ihsan-sa/LED_Light_Panels/USBC_Light_Simple/3D_Models/USB4056-03-A.stp

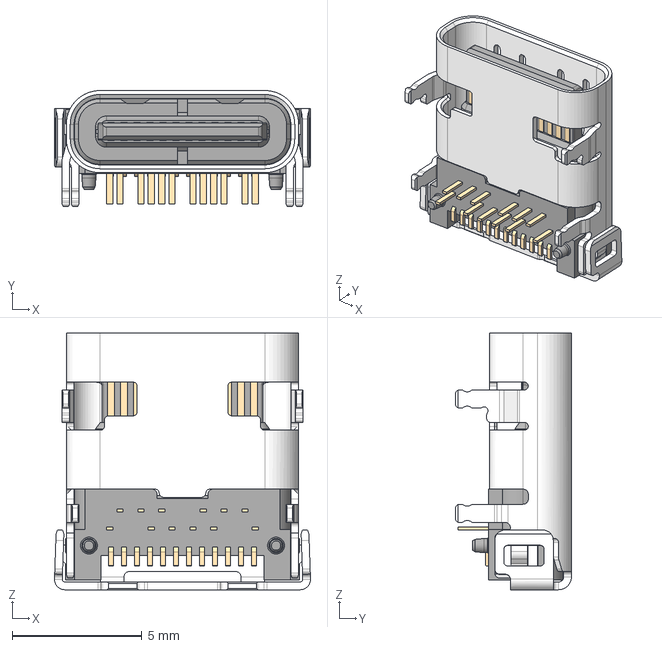
[picture p1: CAD file, 2025-09-14]
USBC_Light_Simple/3D_Models/USB4056-03-A.stp
9.85 x 4.46 x 9.87 mm
