ihsan-sa/LED_Light_Panels/2_LED_WIWO_Compact_Panel/2_LED_WIWO_Compact_Panel/2_LED_WIWO_Compact_Panel.kicad_pcb

## KiCad design 2_LED_WIWO_Compact_Panel/2_LED_WIWO_Compact_Panel/2_LED_WIWO_Compact_Panel.kicad_pcb (2025-10-06)

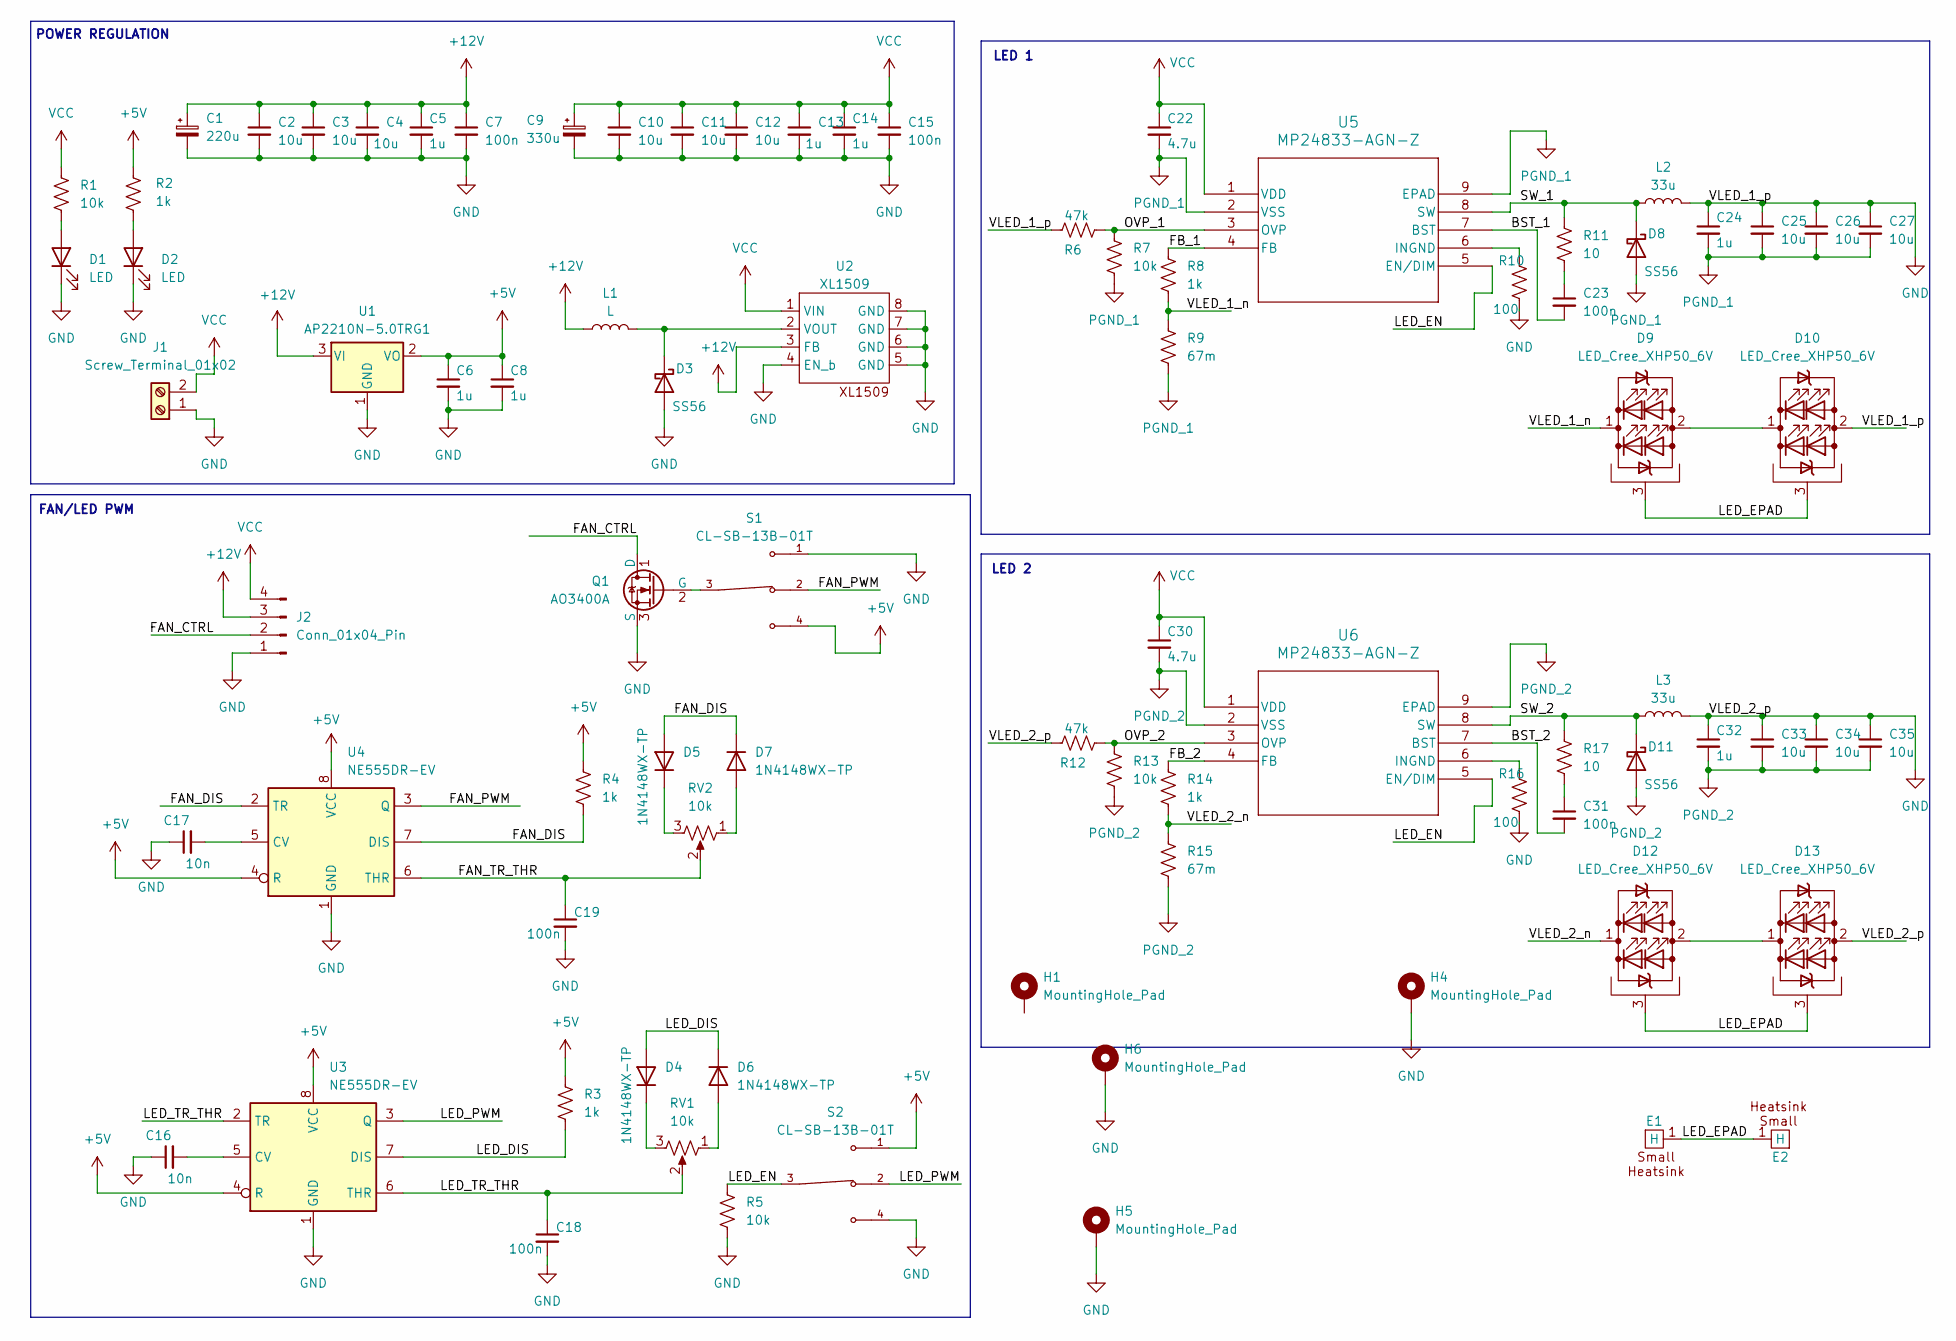
[picture p2: schematic 2_LED_WIWO_Compact_Panel.kicad_sch]

Parts:
C1: 220u; CAP_6.3 X 7.7_PAN
C2, C3, C4, C10, C11, C12, C25, C26, C27, C33, C34, C35: 10u; C_0603_1608Metric_Pad1.08x0.95mm_HandSolder
C5, C6, C8, C13, C14: 1u; C_0402_1005Metric_Pad0.74x0.62mm_HandSolder
C7, C15: 100n; C_0201_0603Metric_Pad0.64x0.40mm_HandSolder
C9: 330u; CAPAE1030X1050N
C16, C17: 10n; R_0201_0603Metric_Pad0.64x0.40mm_HandSolder
C18, C19: 100n; R_0402_1005Metric_Pad0.72x0.64mm_HandSolder
C22, C30: 4.7u; C_0603_1608Metric_Pad1.08x0.95mm_HandSolder
C23, C31: 100n; C_0603_1608Metric_Pad1.08x0.95mm_HandSolder
C24, C32: 1u; C_0603_1608Metric_Pad1.08x0.95mm_HandSolder
D1, D2: LED; LED_0603_1608Metric_Pad1.05x0.95mm_HandSolder
D3, D8, D11: SS56; D_SMA_Handsoldering
D4, D5, D6, D7: 1N4148WX-TP; D_SOD-323_HandSoldering
D9, D10, D12, D13: LED_Cree_XHP50_6V; LED_Cree-XHP50_6V
E1, E2: small_heatsink
H1, H4, H5, H6: MountingHole_Pad; MountingHole_3.2mm_M3_Pad
J1: Screw_Terminal_01x02; TerminalBlock_MaiXu_MX126-5.0-02P_1x02_P5.00mm
J2: Conn_01x04_Pin; PinHeader_1x04_P2.54mm_Vertical
L1: L; CDRH127L125NP-680MC
L2, L3: 33u; IND_SRP1265A-330M
Q1: AO3400A; SOT-23_Handsoldering
R1, R5, R7, R13: 10k; R_0402_1005Metric_Pad0.72x0.64mm_HandSolder
R2, R3, R4, R8, R14: 1k; R_0402_1005Metric_Pad0.72x0.64mm_HandSolder
R6, R12: 47k; R_0402_1005Metric_Pad0.72x0.64mm_HandSolder
R9, R15: 67m; R_2512_6332Metric_Pad1.40x3.35mm_HandSolder
R10, R16: 100; R_0603_1608Metric_Pad0.98x0.95mm_HandSolder
R11, R17: 10; R_0603_1608Metric_Pad0.98x0.95mm_HandSolder
RV1, RV2: 10k; PTV09A-4015F-B104_BRN
S1, S2: CL-SB-13B-01T; SW_CL-SB-13B-01T; PARTREV N/A
U1: AP2210N-5.0TRG1; TSOT-23
U2: XL1509; SOIC-8_3.9x4.9mm_P1.27mm
U3, U4: NE555DR-EV; SOIC-8_3.9x4.9mm_P1.27mm
U5, U6: MP24833-AGN-Z; SOIC-8-1EP_3.9x4.9mm_P1.27mm_EP2.514x3.2mm_ThermalVias

Connections:
+5V: C6.1, C8.1, R2.1, R3.1, R4.1, S1.4, S2.1, U1.2 (VO), U3.4 (R), U3.8 (VCC), U4.4 (R), U4.8 (VCC)
+12V: C1.1, C2.1, C3.1, C4.1, C5.1, C7.1, J2.3, L1.1, U1.3 (VI), U2.3 (FB)
/BST_1: C23.2, U5.7 (BST)
/BST_2: C31.2, U6.7 (BST)
/FAN_CTRL: J2.2, Q1.1 (D)
/FAN_DIS: D5.2 (A), D7.1 (K), R4.2, U4.2 (TR), U4.7 (DIS)
/FAN_PWM: S1.2, U4.3 (Q)
/FAN_TR_THR: C19.1, RV2.2, U4.6 (THR)
/FB_1: R8.1, U5.4 (FB)
/FB_2: R14.1, U6.4 (FB)
/LED_DIS: D4.2 (A), D6.1 (K), R3.2, U3.7 (DIS)
/LED_EN: R5.1, S2.3, U5.5 (EN/DIM), U6.5 (EN/DIM)
/LED_EPAD: D9.3 (PAD), D10.3 (PAD), D12.3 (PAD), D13.3 (PAD), E1.1 (H), E2.1 (H)
/LED_PWM: S2.2, U3.3 (Q)
/LED_TR_THR: C18.1, RV1.2, U3.2 (TR), U3.6 (THR)
/OVP_1: R6.2, R7.1, U5.3 (OVP)
/OVP_2: R12.2, R13.1, U6.3 (OVP)
/SW_1: D8.1 (K), L2.1, R11.1, U5.8 (SW)
/SW_2: D11.1 (K), L3.1, R17.1, U6.8 (SW)
/VLED_1_n: D9.1 (K), R8.2, R9.1
/VLED_2_n: D12.1 (K), R14.2, R15.1
GND: C1.2, C2.2, C3.2, C4.2, C5.2, C6.2, C7.2, C8.2, C9.2, C10.2, C11.2, C12.2, C13.2, C14.2, C15.2, C16.1, C17.1, C18.2, C19.2, C24.1, C25.1, C26.1, C27.1, C32.1, C33.1, C34.1, C35.1, D1.1 (K), D2.1 (K), D3.2 (A), D10.2 (A), D13.2 (A), H4.1, H5.1, H6.1, J1.1, J2.1, L2.2, L3.2, Q1.3 (S), R5.2, R6.1, R10.2, R12.1, R16.2, S1.1, S2.4, U1.1 (GND), U2.4 (EN_b), U2.5 (GND), U2.6 (GND), U2.7 (GND), U2.8 (GND), U3.1 (GND), U4.1 (GND)
unnamed: C23.1, R11.2
unnamed: C31.1, R17.2
unnamed: D1.2 (A), R1.2
unnamed: D2.2 (A), R2.2
unnamed: D3.1 (K), L1.2, U2.2 (VOUT)
unnamed: D4.1 (K), RV1.3
unnamed: D5.1 (K), RV2.3
unnamed: D6.2 (A), RV1.1
unnamed: D7.2 (A), RV2.1
unnamed: D9.2 (A), D10.1 (K)
unnamed: D12.2 (A), D13.1 (K)
unnamed: Q1.2 (G), S1.3
unnamed: C16.2, U3.5 (CV)
unnamed: C17.2, U4.5 (CV)
unnamed: R10.1, U5.6 (INGND)
unnamed: R16.1, U6.6 (INGND)
PGND_1: C22.2, C24.2, C25.2, C26.2, C27.2, D8.2 (A), R7.2, R9.2, U5.2 (VSS), U5.9 (EPAD)
PGND_2: C30.2, C32.2, C33.2, C34.2, C35.2, D11.2 (A), R13.2, R15.2, U6.2 (VSS), U6.9 (EPAD)
VCC: C9.1, C10.1, C11.1, C12.1, C13.1, C14.1, C15.1, C22.1, C30.1, J1.2, J2.4, R1.1, U2.1 (VIN), U5.1 (VDD), U6.1 (VDD)

Notes on the sheet:
FAN/LED PWM
LED 1
LED 2
POWER REGULATION

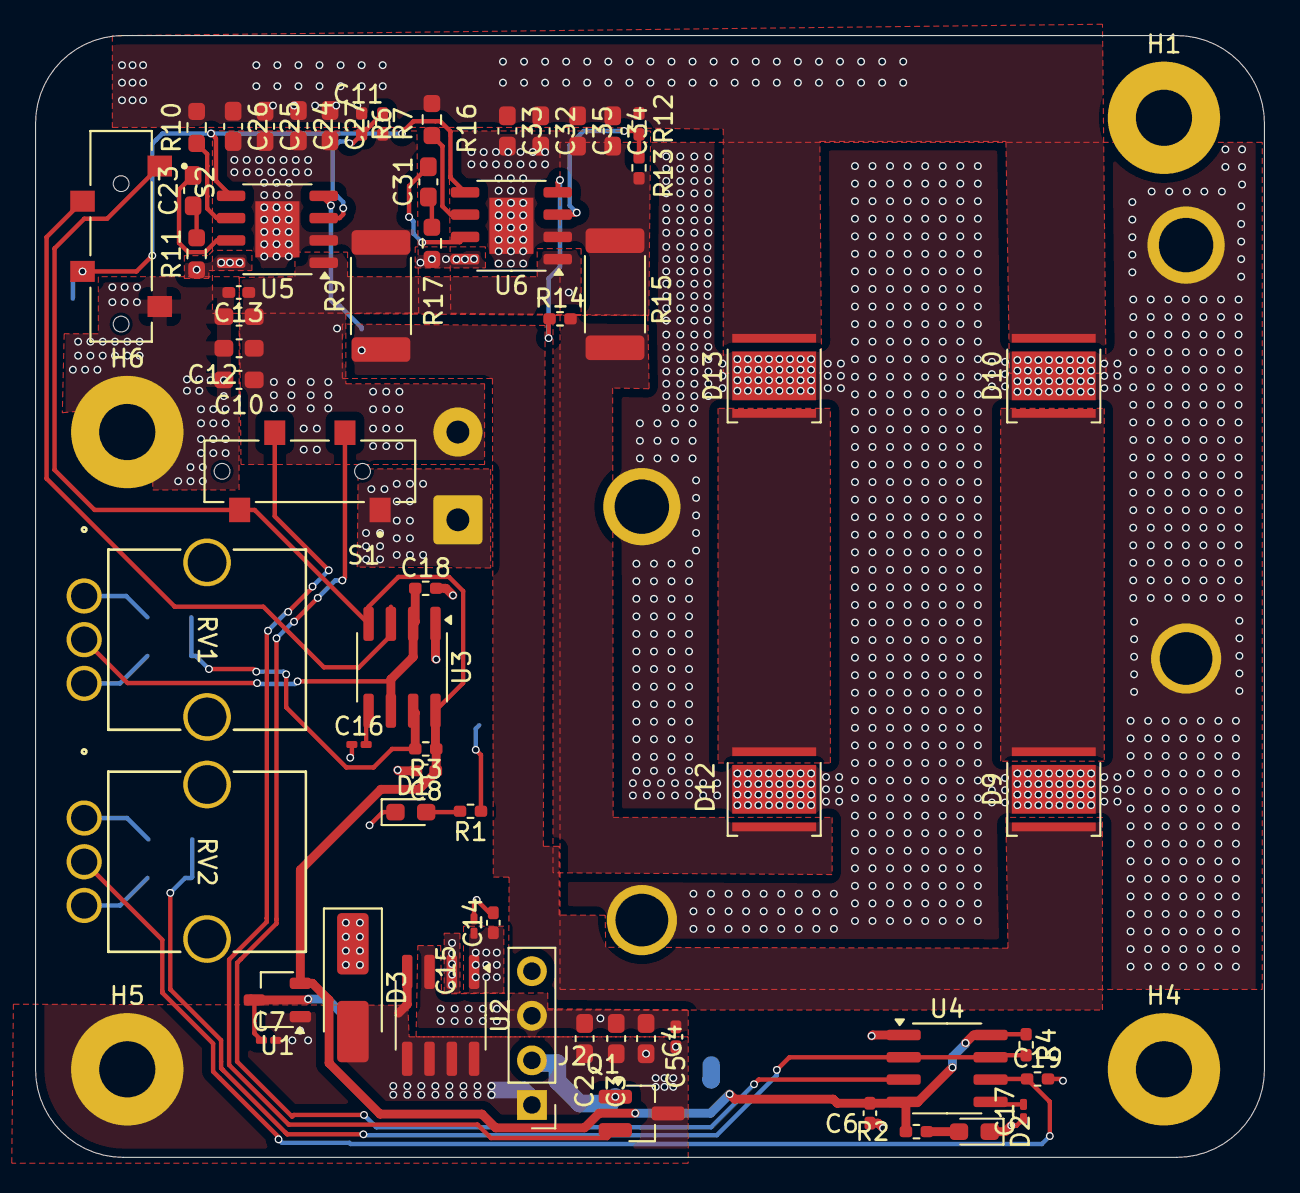
[picture p3: board 2_LED_WIWO_Compact_Panel.kicad_pcb from above]

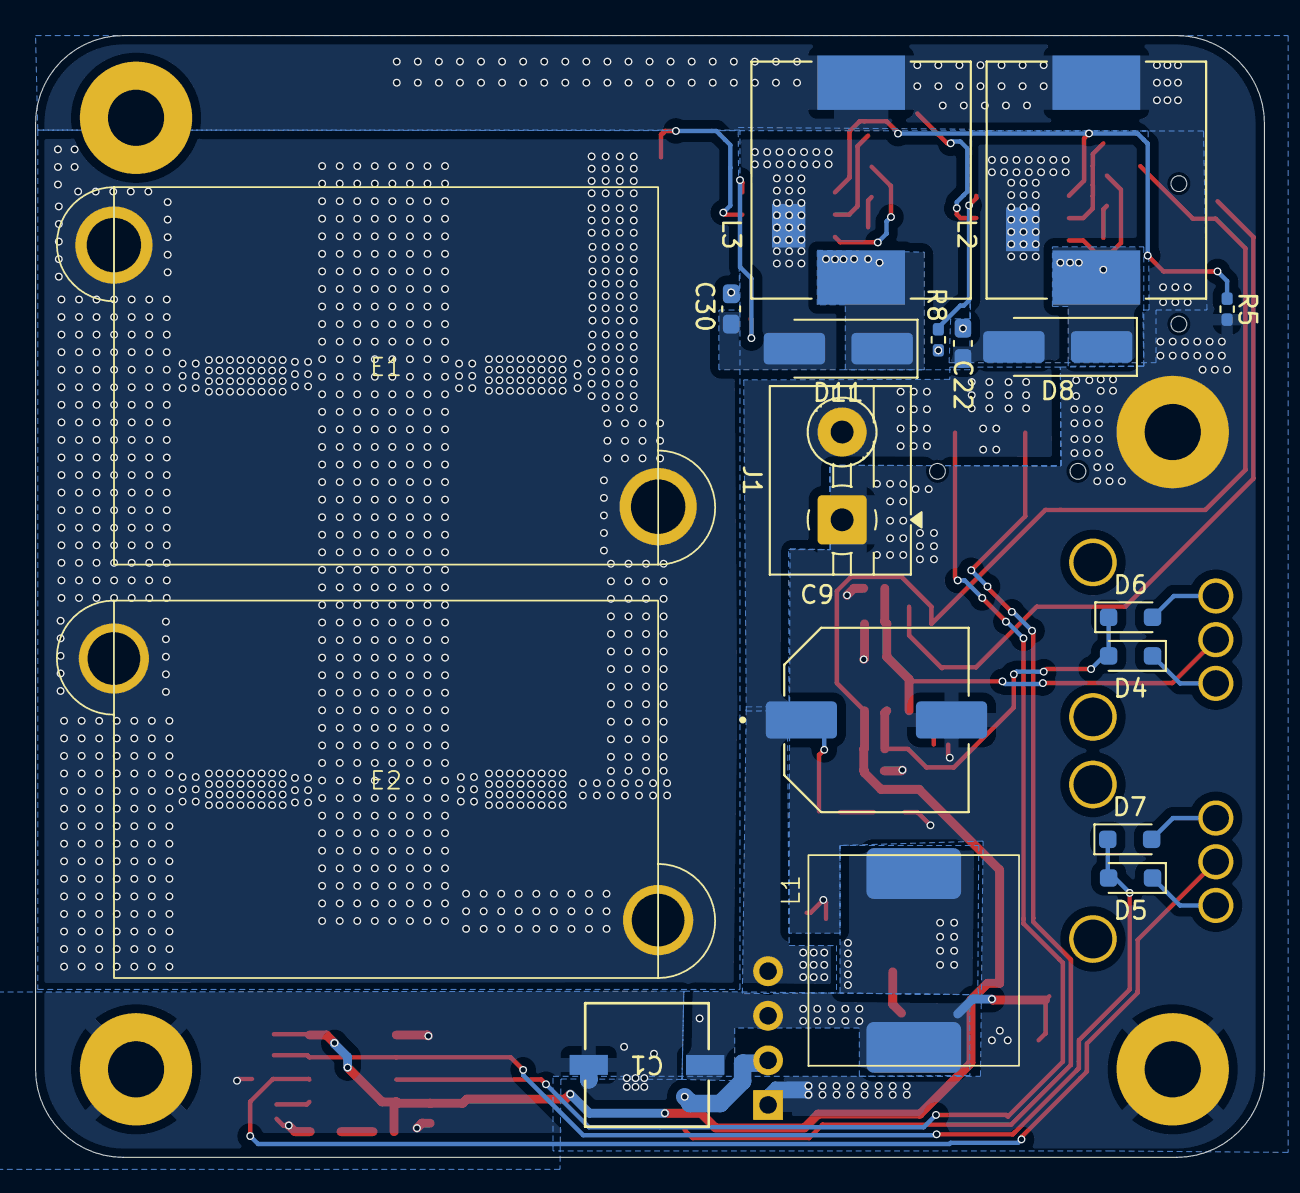
[picture p4: board 2_LED_WIWO_Compact_Panel.kicad_pcb from below]

Board: 2 copper layers, 70.0 x 63.9 mm, 83 parts (18 on the bottom side), 41 nets.
