ihsan-sa/LED_Light_Panels/USBC_Light_Simple/USBC_Light_Simple.kicad_pcb

## KiCad design USBC_Light_Simple/USBC_Light_Simple.kicad_pcb (2025-09-14)

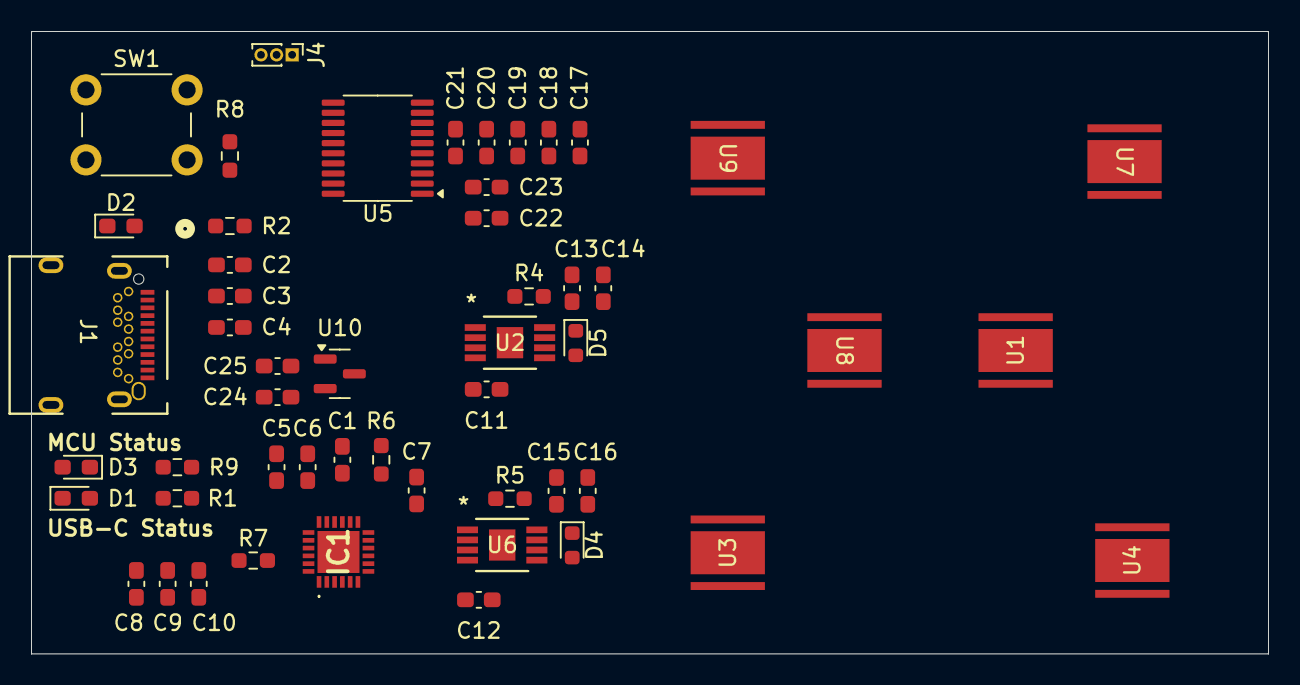
[picture p5: board USBC_Light_Simple.kicad_pcb from above]

Board: 2 copper layers, 79.5 x 40.0 mm, 52 parts (0 on the bottom side), 37 nets, no tracks yet.

Parts:
C1, C4, C6, C7, C10, C11, C12, C13, C15, C19, C20, C25: 100n; C_0603_1608Metric_Pad1.08x0.95mm_HandSolder
C2, C8: 10u; C_0603_1608Metric_Pad1.08x0.95mm_HandSolder
C3, C5, C9, C14, C16, C17, C18, C24: 1u; C_0603_1608Metric_Pad1.08x0.95mm_HandSolder
C21: 10n; C_0603_1608Metric_Pad1.08x0.95mm_HandSolder
C22, C23: *; C_0603_1608Metric_Pad1.08x0.95mm_HandSolder
D1, D2, D3: LED; LED_0603_1608Metric_Pad1.05x0.95mm_HandSolder
D4, D5: D; D_0603_1608Metric
IC1: AP33772SDKZ-13-FA01; AP33772SDKZ13FA01
J1: USB_C_Receptacle; CONN24_4056-03-A_GCT
J4: Screw_Terminal_01x03; PinHeader_1x03_P1.00mm_Vertical
R1, R9: 1k; R_0603_1608Metric_Pad0.98x0.95mm_HandSolder
R2: 100k; R_0603_1608Metric_Pad0.98x0.95mm_HandSolder
R4, R5: RS; R_0603_1608Metric_Pad0.98x0.95mm_HandSolder
R6, R8: 10k; R_0603_1608Metric_Pad0.98x0.95mm_HandSolder
R7: 100; R_0603_1608Metric_Pad0.98x0.95mm_HandSolder
SW1: SW_Push; SW_PUSH_6mm
U1, U3, U4, U7, U8, U9: XHP50B-00-0000-0D0BJ440E; CHIP_D0BJ440E_WFS
U2, U6: AL8861MP-13; MSOP-8EP_DIO
U5: STM32C011F6Px; TSSOP-20_4.4x6.5mm_P0.65mm
U10: AP2127N-3.3; SOT-23

Connections:
+3V3: C17.1, C18.1, C19.1, C20.1, C21.1, C24.1, C25.1, R8.1, U5.4 (VDD), U10.2 (VO)
+5V: C5.1, C6.1, IC1.20 (V5V), U10.3 (VI)
+18V: C7.1, IC1.12 (V18)
/LEDs/LED_1: R4.2, U2.1 (ISENSE), U9.1
/LEDs/LED_2: R5.2, U1.1, U6.1 (ISENSE)
/LEDs/LX_1: D5.2 (A), U2.5 (LX), U2.6 (LX)
/LEDs/LX_2: D4.2 (A), U6.5 (LX), U6.6 (LX)
/LEDs/Thermal_Pad: U1.2, U3.2, U4.2, U7.2, U8.2, U9.2
/LEDs/VSET_1: C11.1, U2.4 (VSET)
/LEDs/VSET_2: C12.1, U6.4 (VSET)
/MCU/I2C_SCL: IC1.5 (SCL), U5.20 (PB6)
/MCU/I2C_SDA: IC1.4 (SDA), U5.1 (PB7)
/MCU/NRST: R8.2, SW1.2, U5.6 (PF2)
/MCU/OSC_IN: C22.2, U5.2 (PC14)
/MCU/OSC_OUT: C23.2, U5.3 (PC15)
/MCU/STATUS_LED: D3.2 (A), U5.11 (PA4)
/MCU/UART_RX: J4.3, U5.8 (PA1)
/MCU/UART_TX: J4.2, U5.7 (PA0)
/USB_C_IC/CC1: IC1.17 (CC1), J1.A5 (CC1)
/USB_C_IC/CC2: IC1.16 (CC2), J1.B5 (CC2)
/USB_C_IC/VOUT: C8.1, C9.1, C10.1, R7.1
/USB_C_IC/data_+: IC1.19 (DP), J1.A6 (D+), J1.B6 (D+)
/USB_C_IC/data_-: IC1.18 (DN), J1.A7 (D-), J1.B7 (D-)
GND: C1.2, C2.2, C3.2, C4.2, C5.2, C6.2, C7.2, C8.2, C9.2, C10.2, C11.2, C12.2, C13.2, C14.2, C15.2, C16.2, C17.2, C18.2, C19.2, C20.2, C21.2, C22.1, C23.1, C24.2, C25.2, D1.1 (K), D2.1 (K), IC1.3 (GND_1), IC1.25 (GND_2), J1.A1 (GND), J1.A12 (GND), J1.B1 (GND), J1.B12 (GND), J4.1, R6.2, R9.1, SW1.1, U2.2 (GND), U2.3 (GND), U5.5 (VSS), U6.2 (GND), U6.3 (GND), U10.1 (GND)
unnamed: D1.2 (A), R1.1
unnamed: D2.2 (A), R2.2
unnamed: D3.1 (K), R9.2
unnamed: C1.1, IC1.15 (IFB)
unnamed: IC1.8 (LED), R1.2
unnamed: IC1.13 (OTP), R6.1
unnamed: IC1.22 (VOUT), R7.2
unnamed: U1.3, U3.1
unnamed: U3.3, U4.1
unnamed: U7.1, U8.3
unnamed: U8.1, U9.3
VBUS: C2.1, C3.1, C4.1, IC1.1 (ISENP), J1.A4 (VBUS), J1.A9 (VBUS), J1.B4 (VBUS), J1.B9 (VBUS), R2.1
VLED: C13.1, C14.1, C15.1, C16.1, D4.1 (K), D5.1 (K), R4.1, R5.1, U2.8 (VIN), U6.8 (VIN)
