ihsan-sa/LED_Light_Panels/Simple_12V_Panel/Simple_12V_Panel.kicad_pcb

## KiCad design Simple_12V_Panel/Simple_12V_Panel.kicad_pcb (2025-09-14)

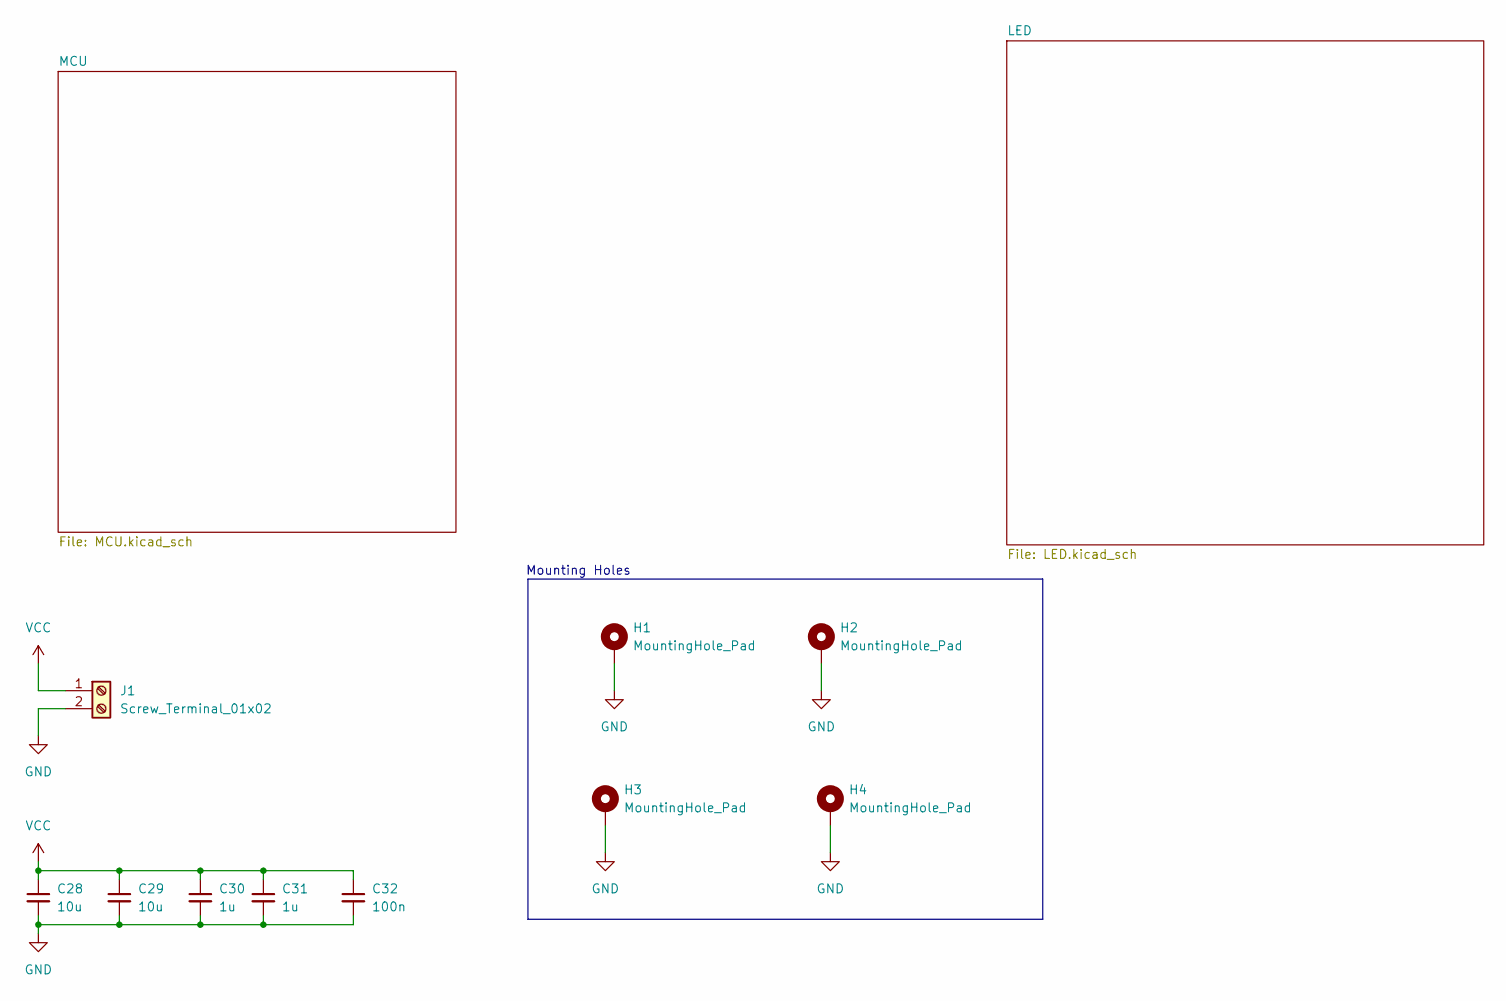
[picture p6: schematic Simple_12V_Panel.kicad_sch]

Parts:
C28, C29: 10u; C_0603_1608Metric_Pad1.08x0.95mm_HandSolder
C30, C31: 1u; C_0603_1608Metric_Pad1.08x0.95mm_HandSolder
C32: 100n; C_0603_1608Metric_Pad1.08x0.95mm_HandSolder
H1, H2, H3, H4: MountingHole_Pad; MountingHole_3.2mm_M3_Pad
J1: Screw_Terminal_01x02; TerminalBlock_MaiXu_MX126-5.0-02P_1x02_P5.00mm

Connections:
GND: C28.2, C29.2, C30.2, C31.2, C32.2, H1.1, H2.1, H3.1, H4.1, J1.2; also elsewhere on the board
VCC: C28.1, C29.1, C30.1, C31.1, C32.1, J1.1; also elsewhere on the board

Notes on the sheet:
Mounting Holes

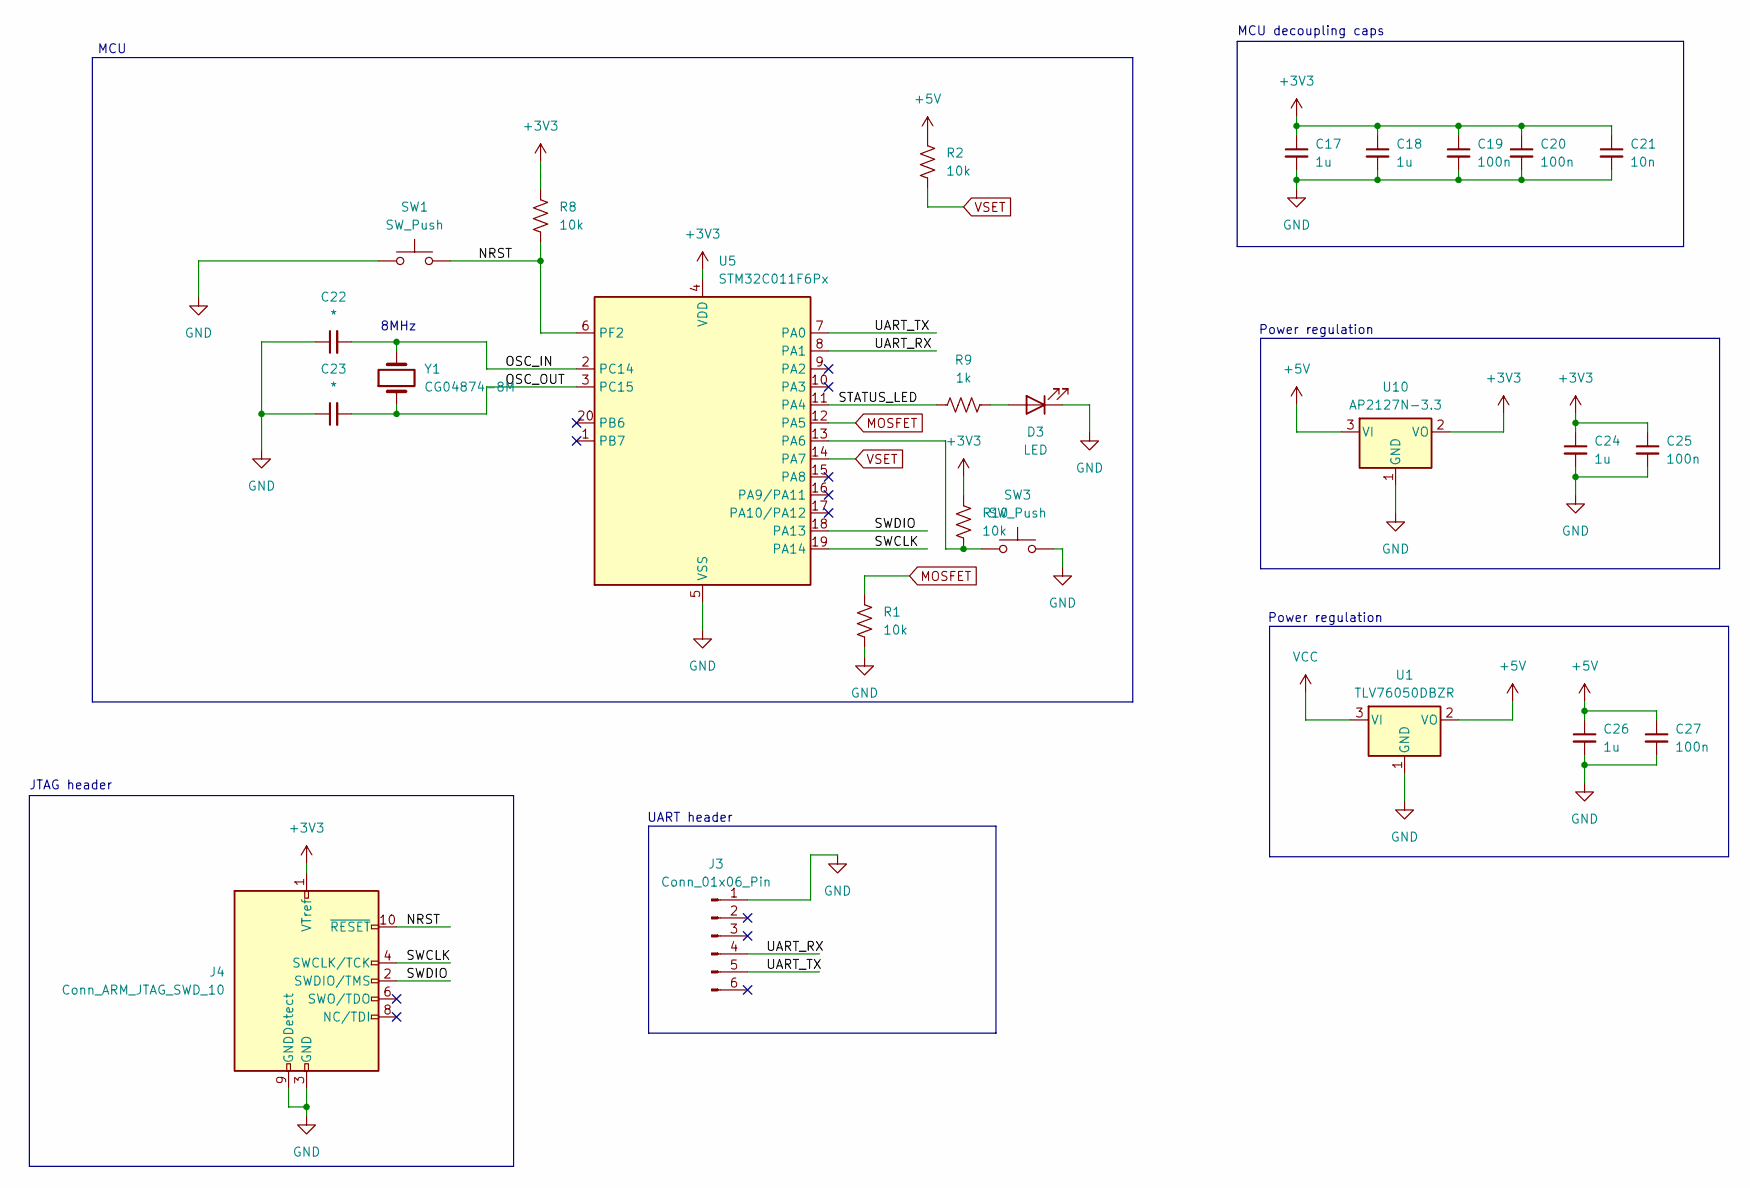
[picture p7: schematic MCU.kicad_sch]

Parts:
C17, C18, C24, C26: 1u; C_0603_1608Metric_Pad1.08x0.95mm_HandSolder
C19, C20, C25, C27: 100n; C_0603_1608Metric_Pad1.08x0.95mm_HandSolder
C21: 10n; C_0603_1608Metric_Pad1.08x0.95mm_HandSolder
C22, C23: *; C_0603_1608Metric_Pad1.08x0.95mm_HandSolder
D3: LED; LED_0603_1608Metric_Pad1.05x0.95mm_HandSolder
J3: Conn_01x06_Pin; PinHeader_1x06_P2.54mm_Vertical
J4: Conn_ARM_JTAG_SWD_10; PinHeader_2x05_P1.27mm_Vertical
R1, R2, R8, R10: 10k; R_0603_1608Metric_Pad0.98x0.95mm_HandSolder
R9: 1k; R_0603_1608Metric_Pad0.98x0.95mm_HandSolder
SW1, SW3: SW_Push; SW_PUSH_6mm
U1: TLV76050DBZR; SOT-23-3
U5: STM32C011F6Px; TSSOP-20_4.4x6.5mm_P0.65mm
U10: AP2127N-3.3; SOT-23
Y1: CG04874-8M; XTAL_CG04874_NDK

Connections:
+3V3: C17.1, C18.1, C19.1, C20.1, C21.1, C24.1, C25.1, J4.1 (VTref), R8.1, R10.1, U5.4 (VDD), U10.2 (VO)
+5V: C26.1, C27.1, R2.1, U1.2 (VO), U10.3 (VI)
/MCU/NRST: J4.10 (~RESET), R8.2, SW1.2, U5.6 (PF2)
/MCU/OSC_IN: C22.2, U5.2 (PC14), Y1.2
/MCU/OSC_OUT: C23.2, U5.3 (PC15), Y1.1
/MCU/STATUS_LED: R9.2, U5.11 (PA4)
/MCU/SWCLK: J4.4 (SWCLK/TCK), U5.19 (PA14)
/MCU/SWDIO: J4.2 (SWDIO/TMS), U5.18 (PA13)
/MCU/UART_RX: J3.4, U5.8 (PA1)
/MCU/UART_TX: J3.5, U5.7 (PA0)
GND: C17.2, C18.2, C19.2, C20.2, C21.2, C22.1, C23.1, C24.2, C25.2, C26.2, C27.2, D3.1 (K), J3.1, J4.3 (GND), J4.5 (GND), J4.9 (GNDDetect), R1.2, SW1.1, SW3.2, U1.1 (GND), U5.5 (VSS), U10.1 (GND); also elsewhere on the board
MOSFET: R1.1, U5.12 (PA5); also elsewhere on the board
unnamed: D3.2 (A), R9.1
unnamed: R10.2, SW3.1, U5.13 (PA6)
VCC: U1.3 (VI); also elsewhere on the board
VSET: R2.2, U5.14 (PA7); also elsewhere on the board

Notes on the sheet:
Power regulation
JTAG header
UART header
8MHz
MCU decoupling caps
MCU

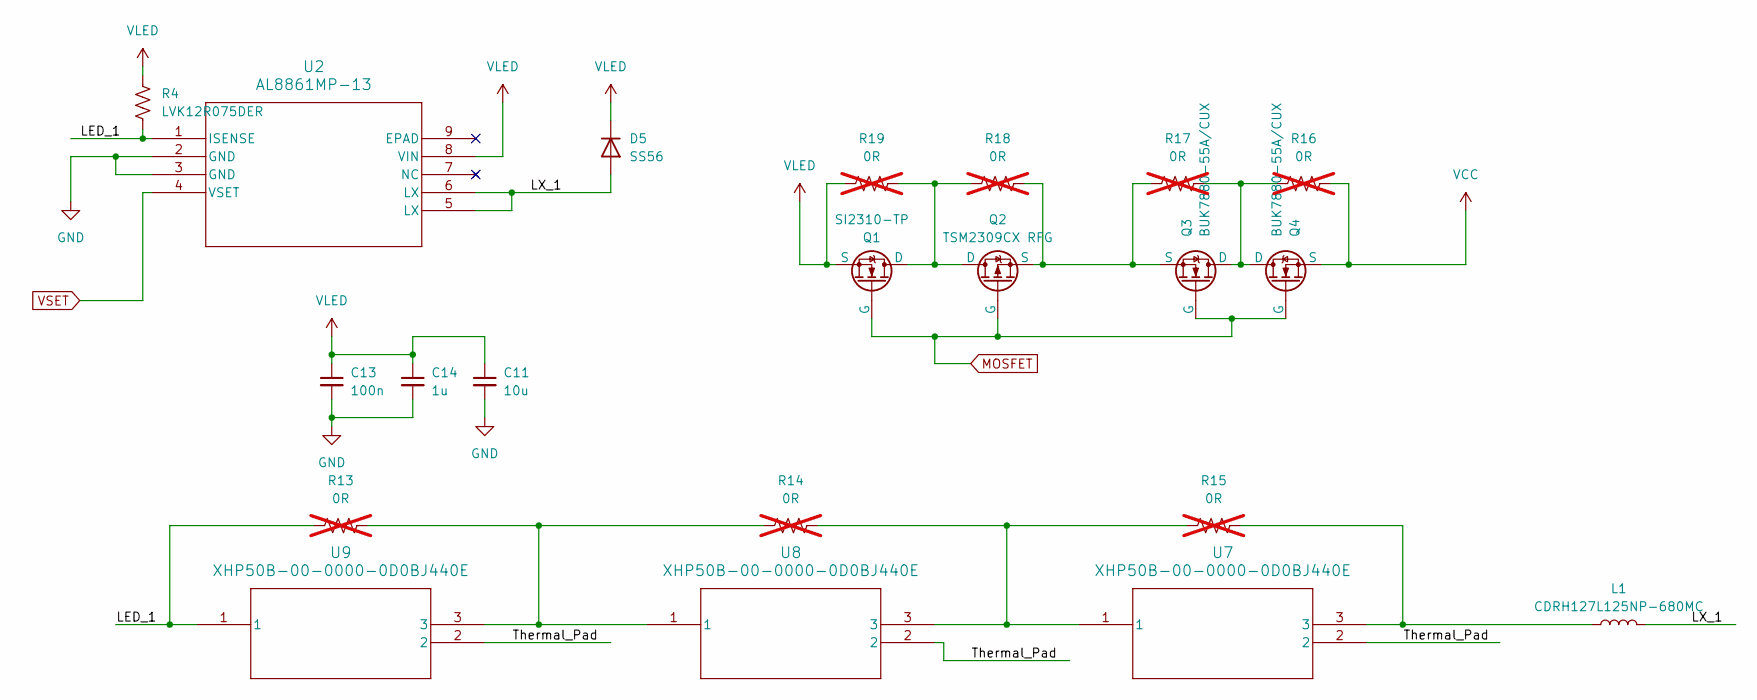
[picture p8: schematic LED.kicad_sch]

Parts:
C11: 10u; C_0603_1608Metric_Pad1.08x0.95mm_HandSolder
C13: 100n; C_0603_1608Metric_Pad1.08x0.95mm_HandSolder
C14: 1u; C_0603_1608Metric_Pad1.08x0.95mm_HandSolder
D5: SS56; D_SMA_Handsoldering
L1: CDRH127L125NP-680MC
Q1: SI2310-TP; SOT-23
Q2: TSM2309CX RFG; SOT-23
Q3, Q4: BUK7880-55A/CUX; SOT-223-3_TabPin2
R4: LVK12R075DER; R_1206_3216Metric_Pad1.30x1.75mm_HandSolder
R13, R14, R15, R16, R17, R18, R19: 0R; R_1206_3216Metric_Pad1.30x1.75mm_HandSolder; not fitted
U2: AL8861MP-13; MSOP-8EP_DIO
U7, U8, U9: XHP50B-00-0000-0D0BJ440E; CHIP_D0BJ440E_WFS

Connections:
/LED/LED_1: R4.2, R13.2, U2.1 (ISENSE), U9.1
/LED/LX_1: D5.2 (A), L1.2, U2.5 (LX), U2.6 (LX)
/LED/Thermal_Pad: U7.2, U8.2, U9.2
GND: C11.2, C13.2, C14.2, U2.2 (GND), U2.3 (GND), U2.EPAD; also elsewhere on the board
MOSFET: Q1.2 (G), Q2.2 (G), Q3.2 (G), Q4.2 (G); also elsewhere on the board
unnamed: L1.1, R15.1, U7.3
unnamed: Q1.1 (D), Q2.1 (D), R18.2, R19.1
unnamed: Q2.3 (S), Q3.3 (S), R17.2, R18.1
unnamed: Q3.1 (D), Q4.1 (D), R16.2, R17.1
unnamed: R13.1, R14.2, U8.1, U9.3
unnamed: R14.1, R15.2, U7.1, U8.3
VCC: Q4.3 (S), R16.1; also elsewhere on the board
VLED: C11.1, C13.1, C14.1, D5.1 (K), Q1.3 (S), R4.1, R19.2, U2.8 (VIN)
VSET: U2.4 (VSET); also elsewhere on the board

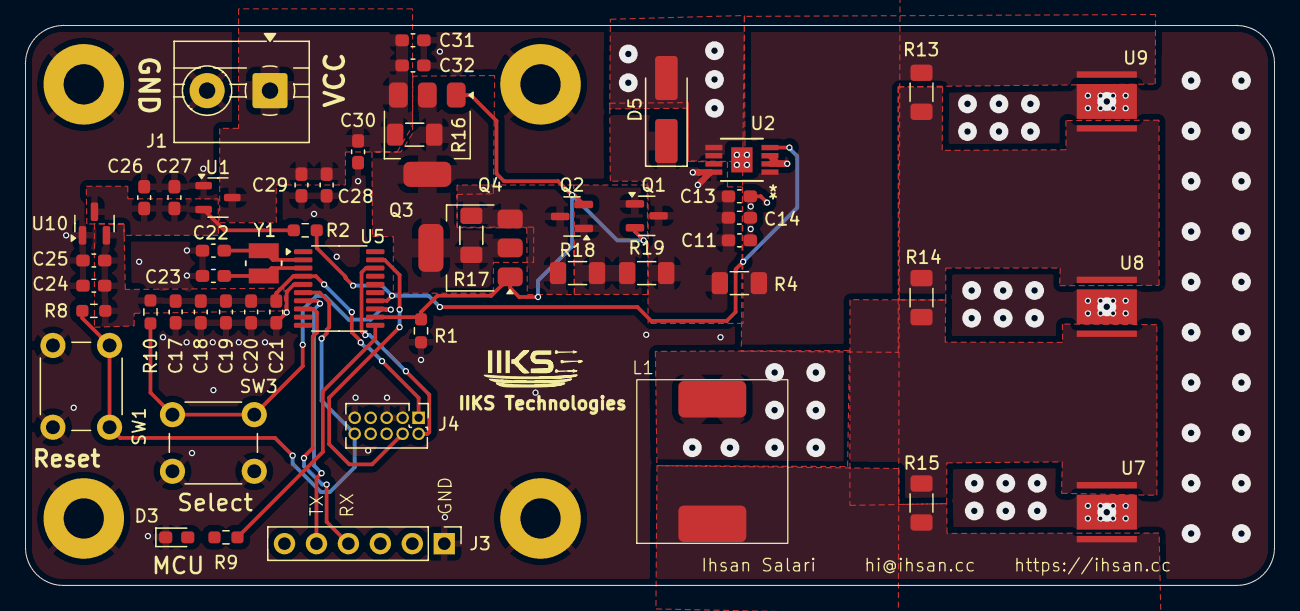
[picture p9: board Simple_12V_Panel.kicad_pcb from above]

Board: 2 copper layers, 99.3 x 44.5 mm, 56 parts (0 on the bottom side), 26 nets.
