ihsan-sa/LED_Light_Panels/Simple_12V_Panel/FW/Core/Src/main.c

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
/* Includes ------------------------------------------------------------------*/
#include "main.h"

/* USER CODE BEGIN Includes */
#include "mode.h"
/* USER CODE END Includes */


TIM_HandleTypeDef htim3;
TIM_HandleTypeDef htim14;

UART_HandleTypeDef huart1;

/* USER CODE BEGIN PV */
uint8_t state = 0;

/* USER CODE END PV */

void SystemClock_Config(void);
static void MX_GPIO_Init(void);
static void MX_USART1_UART_Init(void);
static void MX_TIM14_Init(void);
static void MX_TIM3_Init(void);
/**
  * @brief  The application entry point.
  * @retval int
  */
int main(void)
{

  /* MCU Configuration--------------------------------------------------------*/

  /* Reset of all peripherals, Initializes the Flash interface and the Systick. */
  HAL_Init();

  /* Configure the system clock */
  SystemClock_Config();

  /* Initialize all configured peripherals */
  MX_GPIO_Init();
  MX_USART1_UART_Init();
  MX_TIM14_Init();
  MX_TIM3_Init();
  /* USER CODE BEGIN 2 */
  HAL_TIM_PWM_Start(&htim14, TIM_CHANNEL_1);
  HAL_TIM_PWM_Start(&htim3, TIM_CHANNEL_2);


int count = 0;
int dir = 0;

  /* USER CODE END 2 */

  /* Infinite loop */
  /* USER CODE BEGIN WHILE */
  while (1)
  {
	  if(get_mode() == 2){
		  htim3.Instance->CCR2 = count;
		  HAL_Delay(3);
		  if(dir == 0){
		    count ++;

		  }else{
		    count--;
		  }

		  if(count == 120){
		    dir = 1;
		  } else if(count == 0){
		    dir = 0;
		  }
	  }
	  else if(get_mode() == 1){
		  htim3.Instance->CCR2 = 120;
	  } else if(get_mode() == 0){
		  htim3.Instance->CCR2 = 0;
	  }


    /* USER CODE END WHILE */

    /* USER CODE BEGIN 3 */
  }
  /* USER CODE END 3 */
}

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
