ihsan-sa/LED_Light_Panels/Simple_12V_Panel/FW/Core/Inc/main.h

#define MOSFET_Pin GPIO_PIN_5
#define MOSFET_GPIO_Port GPIOA
#define BTN_INT_Pin GPIO_PIN_6
#define BTN_INT_GPIO_Port GPIOA
#define BTN_INT_EXTI_IRQn EXTI4_15_IRQn
#define VSET_Pin GPIO_PIN_7
#define VSET_GPIO_Port GPIOA
