ihsan-sa/LED_Light_Panels/Simple_12V_Panel/FW/Core/Inc/mode.h

/*
 * mode.h
 *
 *  Created on: Sep 5, 2025
 *      Author: ihsan
 */

#ifndef INC_MODE_H_
#define INC_MODE_H_

#include <stdint.h>

void set_mode(uint8_t mode, uint32_t time);
uint8_t get_mode();

#endif /* INC_MODE_H_ */
