ihsan-sa/LED_Light_Panels/(commit log)

2025-09-14 {Simple_12V_Panel} Done.
    [LED.kicad_sch, MCU.kicad_sch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]
2025-09-14 {USBC_LIght_Simple} Relocated project
    [LEDs.kicad_sch, MCU.kicad_sch, USB4056-03-A.stp, USBC_Light_Simple.kicad_pcb, USBC_Light_Simple.kicad_sch, USB_C_IC.kicad_sch]
2025-10-03 created new compact LED panel project
    [2_LED_WIWO_Compact_Panel.kicad_pcb, 2_LED_WIWO_Compact_Panel.kicad_sch]
2025-10-05 finished v1 schem and moving to layout
    [2_LED_WIWO_Compact_Panel.kicad_pcb, 2_LED_WIWO_Compact_Panel.kicad_sch]
2025-10-06 v1 route done
    [2_LED_WIWO_Compact_Panel.kicad_pcb, 2_LED_WIWO_Compact_Panel.kicad_sch]
2025-10-06 minor changes
    [2_LED_WIWO_Compact_Panel.kicad_pcb]
