ihsan-sa/LED_Light_Panels/(notices)

Notices in the files:
Simple_12V_Panel/FW/Core/Inc/main.h:
Copyright (c) 2025 STMicroelectronics.
All rights reserved.
This software is licensed under terms that can be found in the LICENSE file
USBC_Light_Simple/3D_Models/USB4056-03-A.stp:
author */ ('License CC BY-ND 4.0'),
